VeenaveeSamarasinghe/-User-Presence-Based-Smart-Table-Lamp-with-Study-Time-Tracking-Application/Control board.jpg

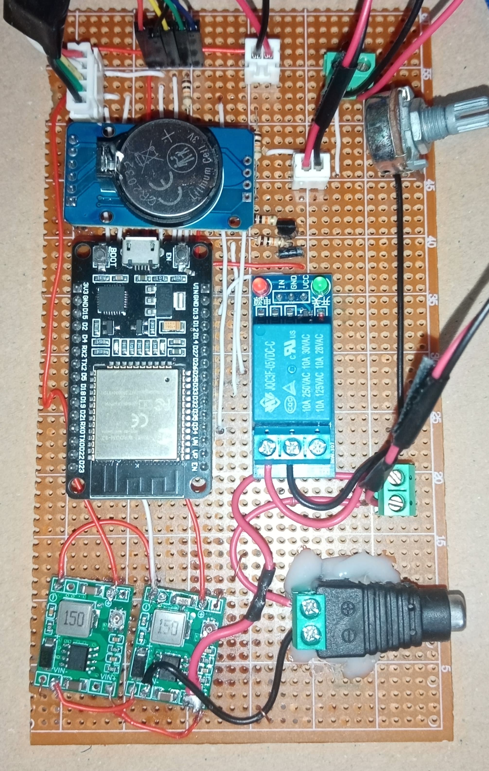
Control board.jpg
