VeenaveeSamarasinghe/-User-Presence-Based-Smart-Table-Lamp-with-Study-Time-Tracking-Application/Final Product.jpg

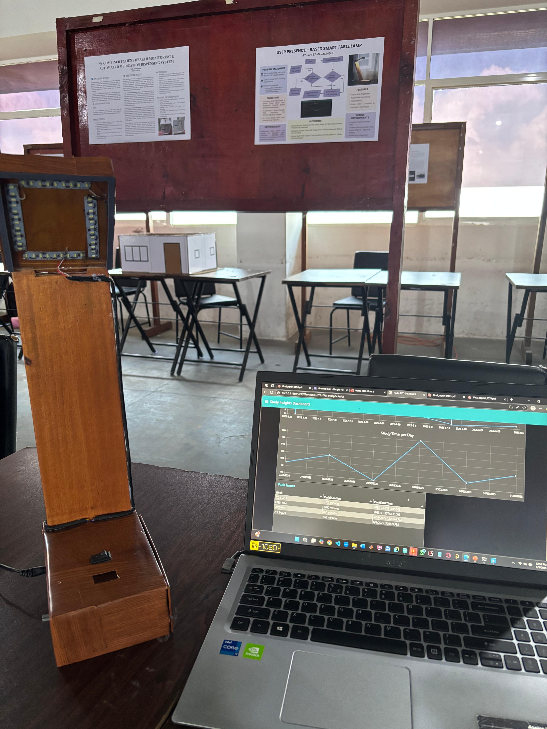
Final Product.jpg
