VeenaveeSamarasinghe/-User-Presence-Based-Smart-Table-Lamp-with-Study-Time-Tracking-Application/Final_detailed_Presentation.pdf

27-Jan-25 | Individual Design Project 2025

### D.N.V. SAMARASINGHE D/ENG/23/0053/ET STREAM : ET Final Presentation of Individual Design Project

# USER PRESENCE - BASED SMART TABLE LAMP

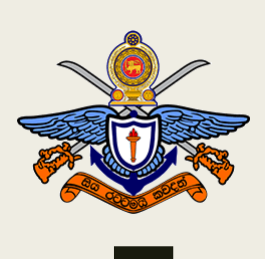
[picture p3: figure]

# Content of the Presentation

■ | Problem Identification
■ | Objectives
■ | Literature Review
■ | Market Survey
■ | System Design
■ | Flow Chart
■ | Critical Design Decisions
■ | Circuit Design
■ | Software implementation
■ | Results and discussion
■ | Problems Encountered and Solutions
■ | Cost Estimation
■ | Gantt Chart
■ | References
27-Jan-25 | Individual Design Project 2025 | 2

# Problem

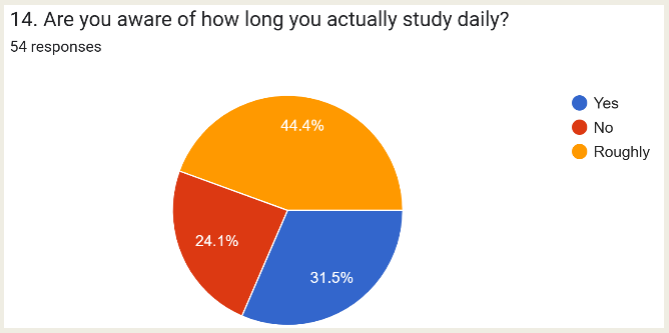
[picture p4: figure]

# Identification

## ■ Manually turning the lamp on and off is inconvenient

## ■ Lack of Study Time Tracking

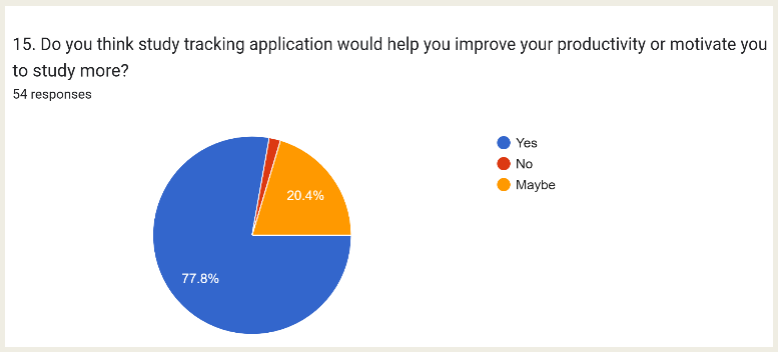
[picture p5: figure]

27-Jan-25 | Individual Design Project 2025 | 3

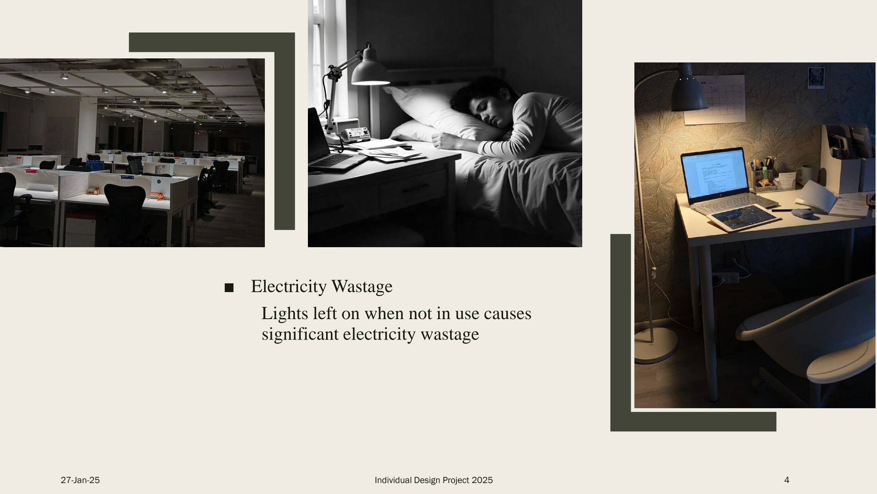
[picture p6: page 4]

## ■ Electricity Wastage

## Lights left on when not in use causes significant electricity wastage

27-Jan-25 | Individual Design Project 2025 | 4

# Objectives

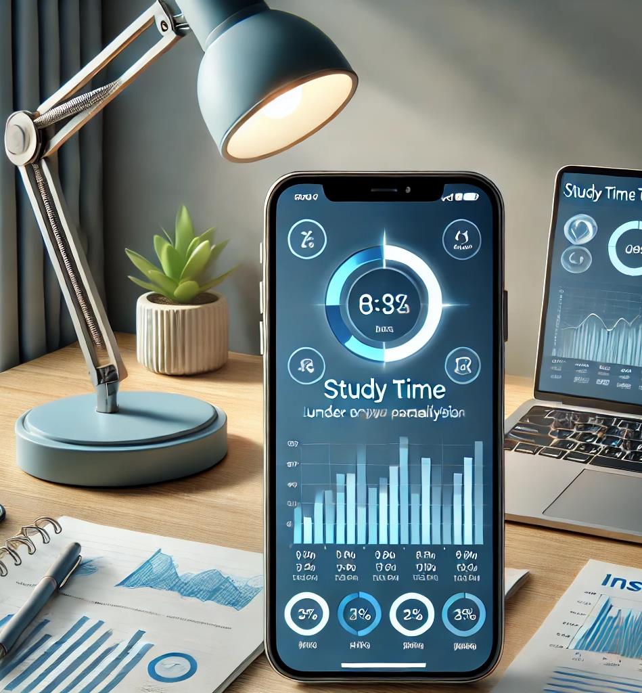
[picture p7: figure]

## 1. To design and implement a smart table lamp with

automatic control based on user preferences.

## 2. To develop a user-friendly web interface for

monitoring lamp usage.

3. To track study time and analyze user patterns.
27-Jan-25 | Individual Design Project 2025 | 5

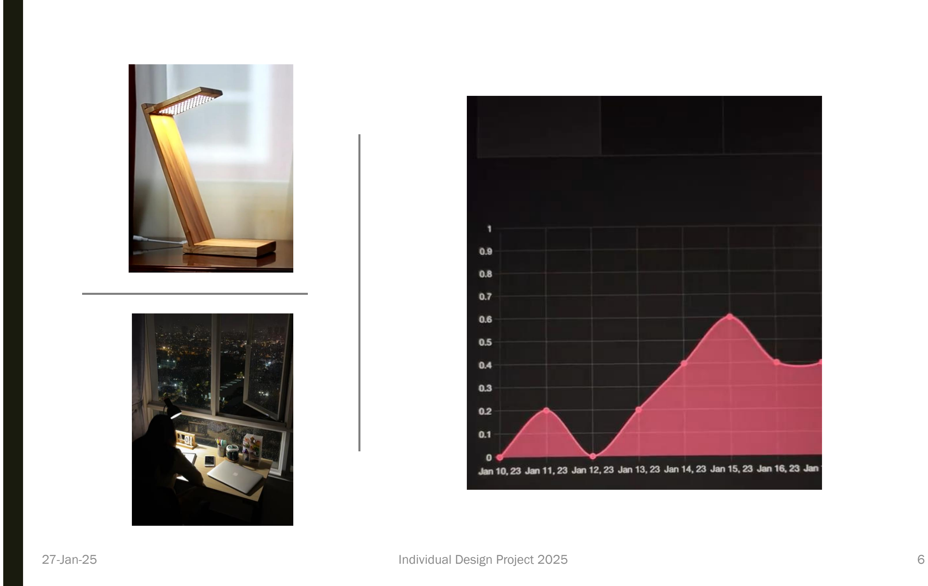
[picture p8: page 6]

27-Jan-25 | Individual Design Project 2025 | 6

# Literature Review

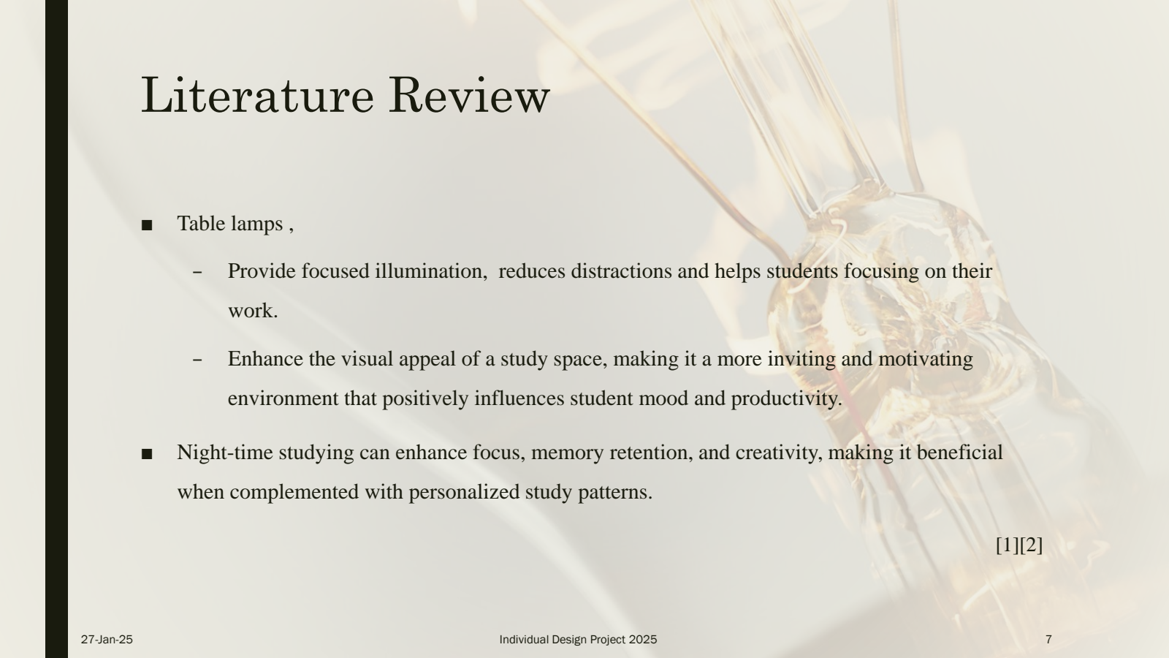
[picture p9: page 7]

■ | Table lamps ,
– | Provide focused illumination, reduces distractions and helps students focusing on their

work.

### – Enhance the visual appeal of a study space, making it a more inviting and motivating

environment that positively influences student mood and productivity.

■ Night-time studying can enhance focus, memory retention, and creativity, making it beneficial

when complemented with personalized study patterns.

[1][2]

27-Jan-25 | Individual Design Project 2025 | 7

Individual Design Project 2025 | 8

### - Energy Consumption and Emissions in Sri Lanka

In 2022, Sri Lanka's energy-related CO₂ emissions reached 18 million tonnes, contributing to 0.05% of

global emissions. There’s a 74% increase in emissions since 2000, highlighting the need for energy-efficient

### solutions. [3]

### - Energy Efficiency of LED Lighting

LED lamps consume significantly less energy compared to incandescent or halogen bulbs, offering up to

85% energy savings.

Smart lighting systems that automatically adjust brightness reduces electricity consumption by 30%.

Additionally, leaving lights on unnecessarily contributes to 5-10% of household electricity bills. [4][5][6]

27-Jan-25

# Key technologies relevant to the project

17-Sep-23 | Individual Design Project 2024/2025 | 9
■ | Cloud Firestore is a real-time cloud database to store sensor readings, lamp status, and study
| session data.
■ | MQTT is a lightweight communication protocol used to transmit data from the ESP32 to
| Firebase efficiently.
■ | Node-RED is a low code programming tool that stores data using flow-based graphs and tables
| through a web-based dashboard.

# Sources relevant to the design choices

## ■ The Pomodoro Technique

– | Inspired the timer feature. A buzzer alerts the user after every 25 minutes of
| study to take a 5-minute break
| (for the demonstration buzzer alerts after 2 minutes )

■ Based on literature review, LED strips were used to ensure better energy efficiency.

■ Survey results showed brightness

control was important,

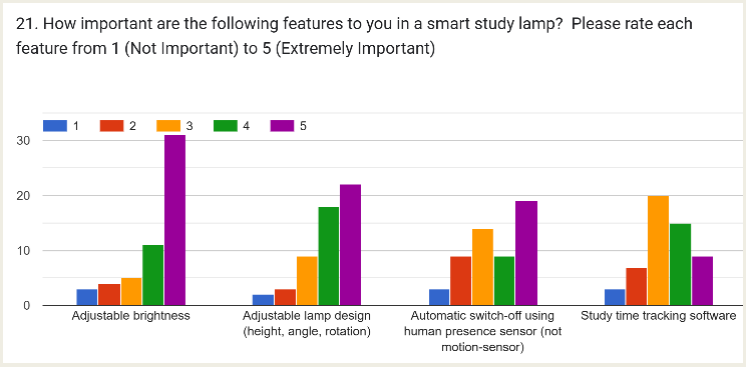
[picture p10: figure]

– A potentiometer was added

for manual adjustment,

– Lamp panel was made

adjustable in height, angle,

and rotation.

■ Many users preferred automatic

control,

– Human presence sensor

was used to switch the

lamp off

# Market Survey

Individual Design Project 2025 | 12
Lamp | Name | Features | Price | Available at

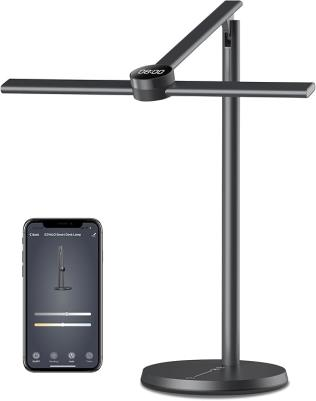
[picture p11: figure]

| EZVALO Smart Desk Lamp | APP Control Eye-Caring Auto-Dimming Led Desk Lamp 3 Color Temperature Works with Alexa & Google Assistant | LKR 17,812.89 | https://www.amazon.comhttps://rb.gy/qmpmoe

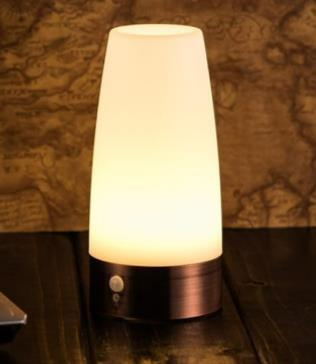
[picture p12: figure]

| ZEEFO Retro LED Night Light PIR Motion Sensor Light | Light will automatically turn on when a user pass within 6 feet of the sensor, will automatically turn off after about 15-20 seconds | LKR 4,845.08 | https://www.amazon.com/https://rb.gy/bpd5t2

27-Jan-25

Individual Design Project 2025 | 13
Lamp | Name | Features | Price | Available at

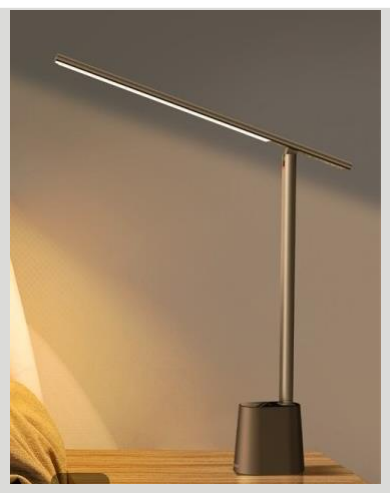
[picture p13: figure]

| Baseus LED Desk Lamp Auto-Dimming Table Lamp | 47 " Wide Rectangular Illumination Adjustable Brightness Built-in battery staying up to 13 hrs. | LKR 10,122.34 | https://baseusonline.com/https://rb.gy/d997z4

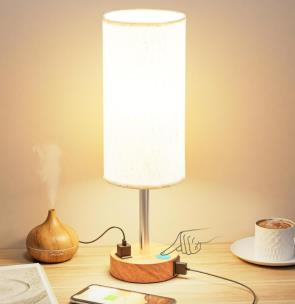
[picture p14: figure]

| 3 Way Dimmable Touch Lamp | Touch Control USB & USB-C Charging Ports and outlet | LKR 5,648.13 | https://www.amazon.com/https://rb.gy/8pntbj
| Xiaomi Mi Smart LED Desk Lamp | Adjustable brightness and color temperature App-controlled Lacks advanced motion detection | LKR 25,724.99 | https://www.aliexpress.com/item/32967694580.html (https://www.aliexpress.com/item/32967694580.html) https://www.mi.com/ae/product/mi-smart-led-desk-lamp-pro/ (https://www.mi.com/ae/product/mi-smart-led-desk-lamp-pro/)

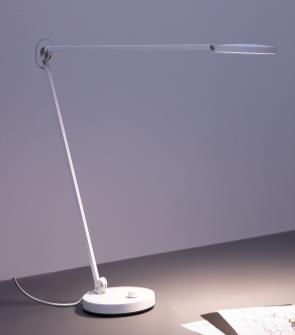
[picture p15: figure]

27-Jan-25

# Potential user base and application areas

■ | Students and Academics

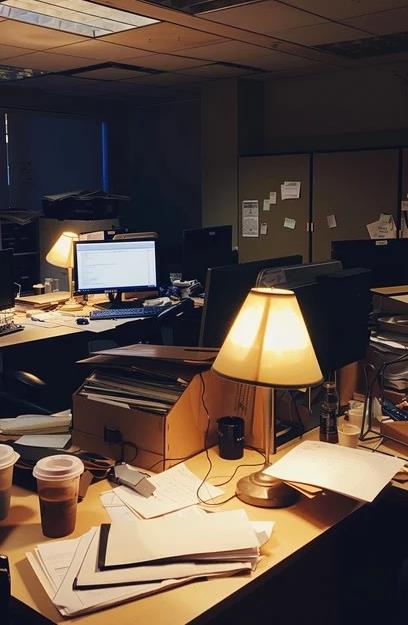
[picture p16: figure]
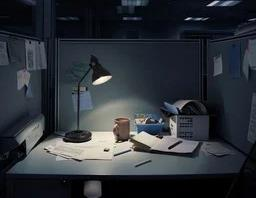
[picture p17: figure]

– | Hostel students who share rooms can

### have their own lighting without bothering their roommates

### – Feedbacks on lamp usage patterns can inspire better time management and study habits

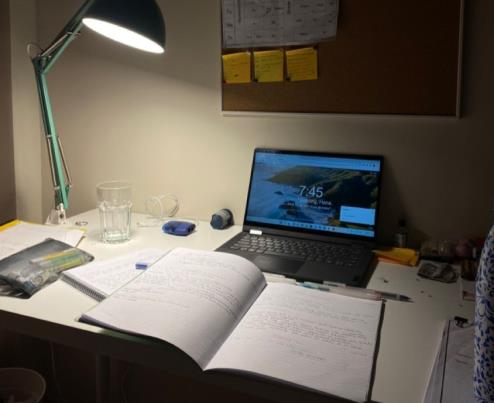
[picture p18: figure]

■ | Healthcare and Elderly Care
– | Enhance safety and provide hands-free

### operation for people with limited

mobility.

■ | Office and Workspace Settings
– | For busy office environments where

### users frequently move

27-Jan-25 | Individual Design Project 2025 | 14

# System Design

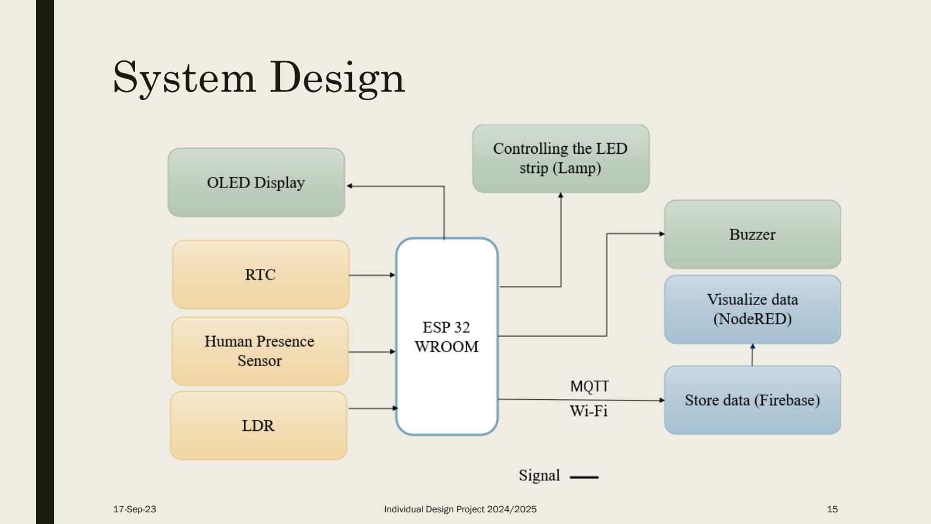
[picture p19: page 15]

# Flow chart

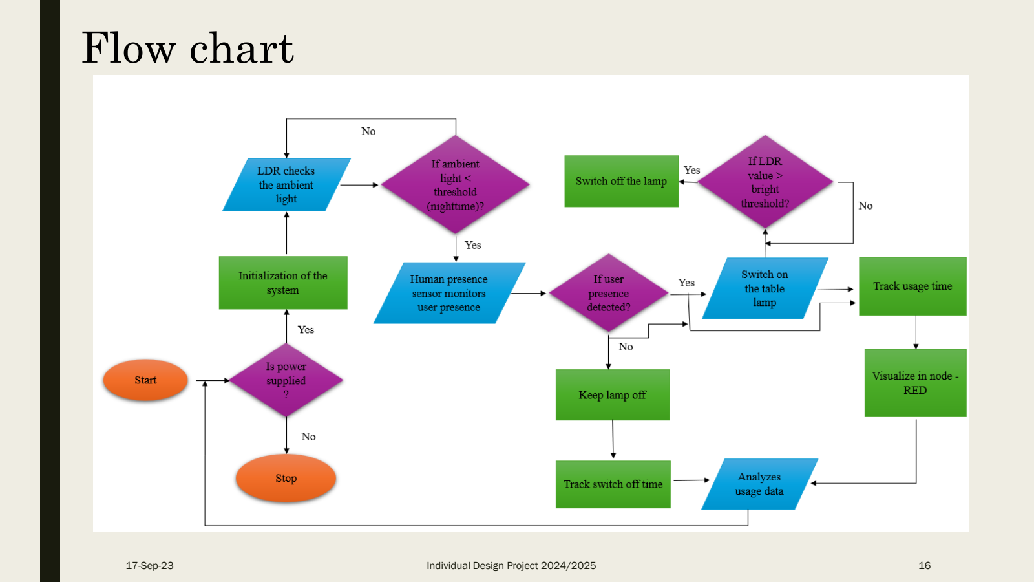
[picture p20: page 16]

## Flows of the Node-RED Dashboard for Study Time Analysis

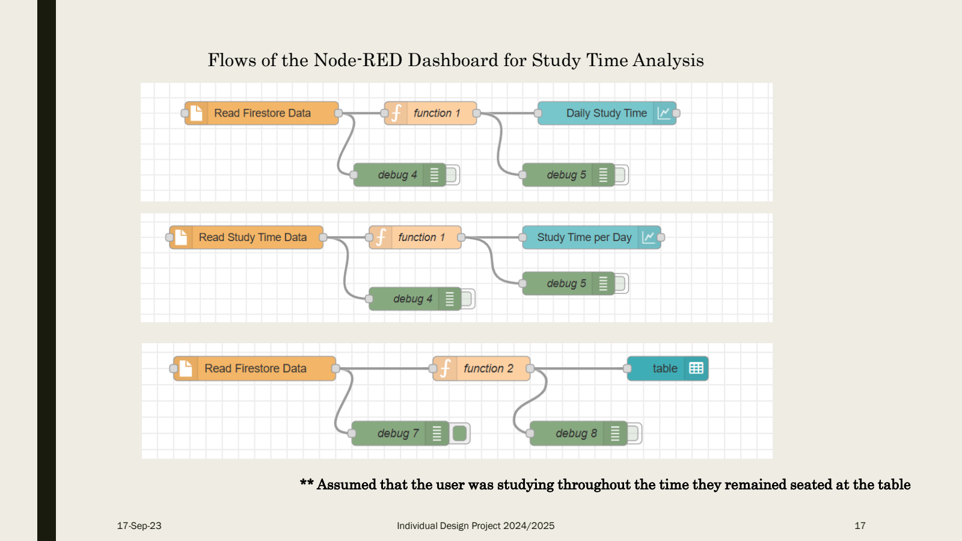
[picture p21: page 17]

** Assumed that the user was studying throughout the time they remained seated at the table

Side view | Front view

# 3-Dimensional view

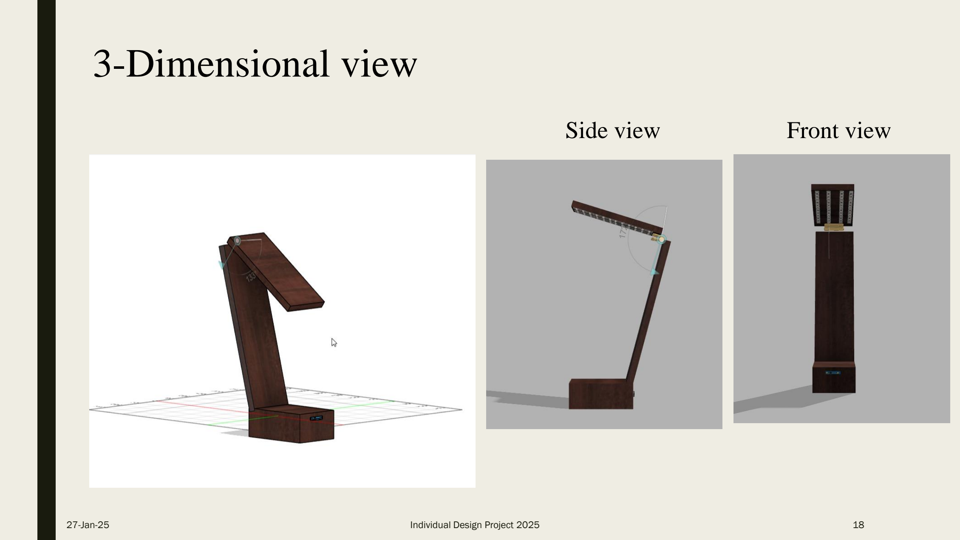
[picture p22: page 18]

Individual Design Project 2025 | 18

27-Jan-25

# Critical Design Decisions

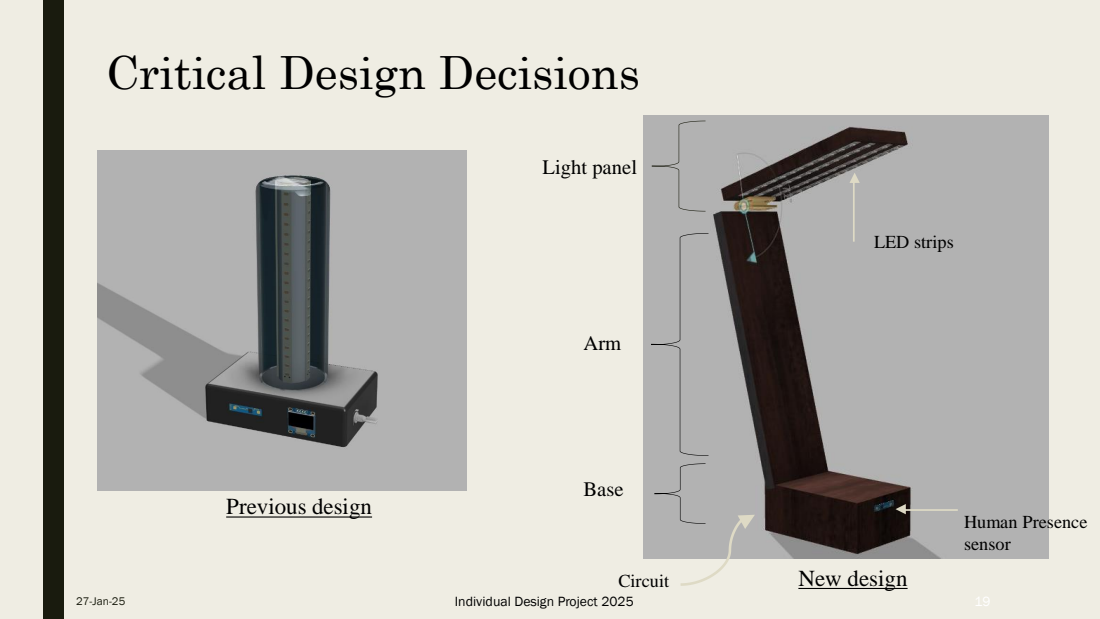
[picture p23: page 19]
Individual Design Project 2025; Previous design; New design; LED strips; Human Presence sensor; Circuit; Light panel; Arm; Base; 27-Jan-25

## ■ Focused Light Projection

The lamp is designed to direct light to a specific area instead of spreading it everywhere.

## ■ Wooden Casing

## to minimize heat transfer as the LED strips generate some heat when powered for long

periods.
maintaining an aesthetic look.

## ■ Adjustable Panel

Allow the user to change the lighting angle for different tasks.

## ■ Dual Power Options

To increase portability and ensure the lamp can work even during power outages.

## 12V adapter (for continuous use)

12V battery pack (for backup use).

■ The lamp projects light over approximately 1 meter with a 180-degree spread.

27-Jan-25 | Individual Design Project 2025 | 20

# Base enclosure 3D view

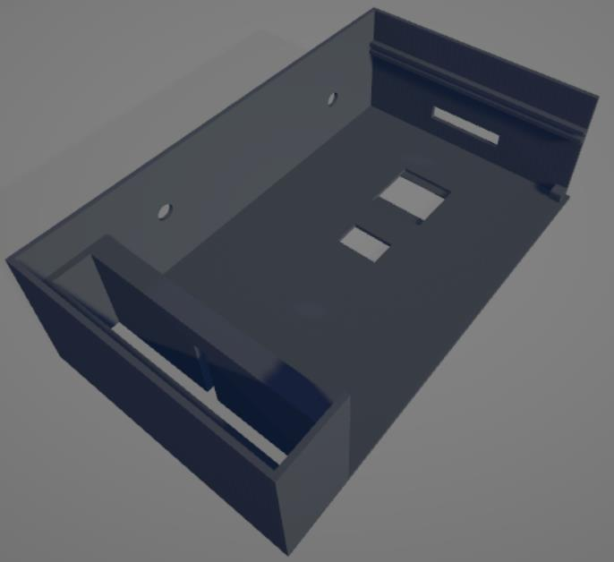
[picture p24: figure]
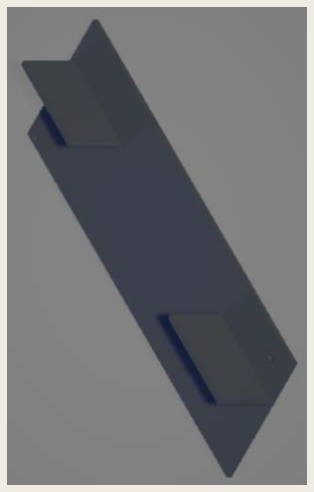
[picture p25: figure]
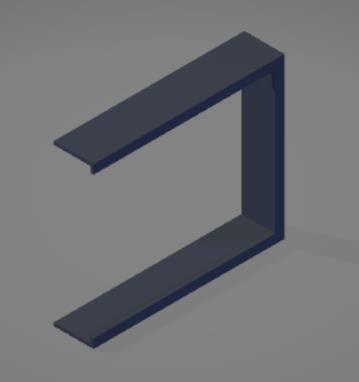
[picture p26: figure]

Casing | Slider | Panel casing

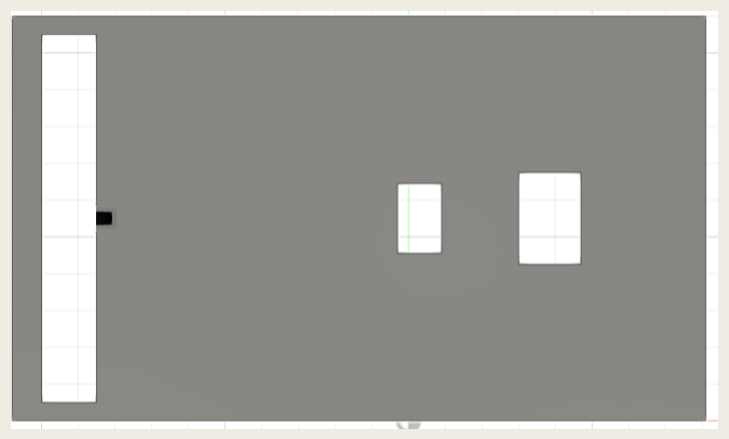
[picture p27: figure]
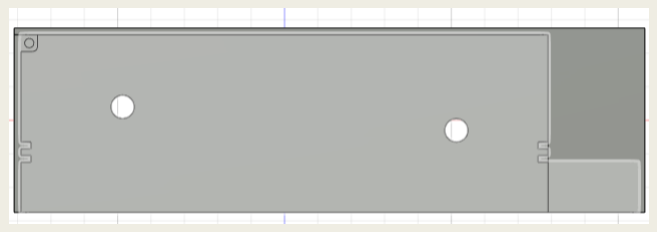
[picture p28: figure]

Top view | Side view

# Circuit

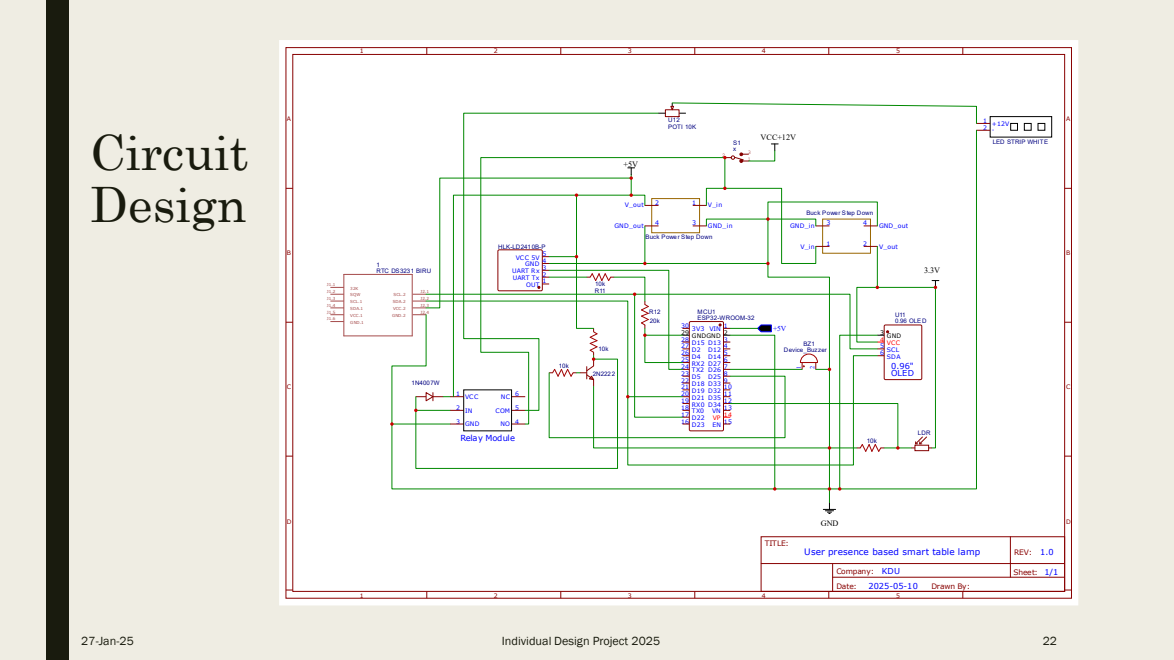
[picture p29: page 22]
Individual Design Project 2025; Design; 27-Jan-25

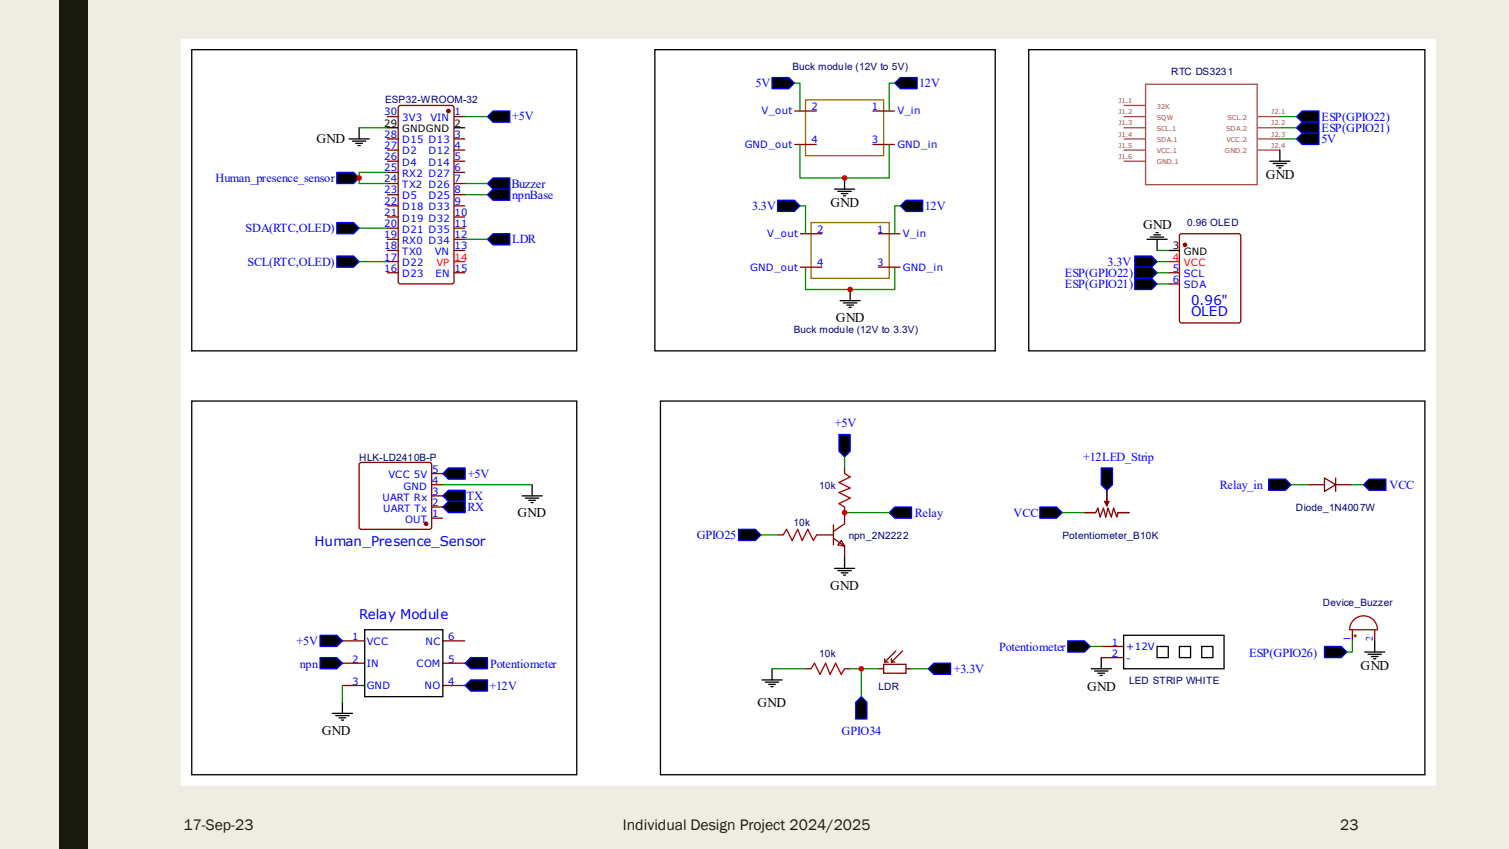
[picture p30: page 23]
n n ase; elay; elay in; otentiometer; tri

man resence sensor

# Software Implementation

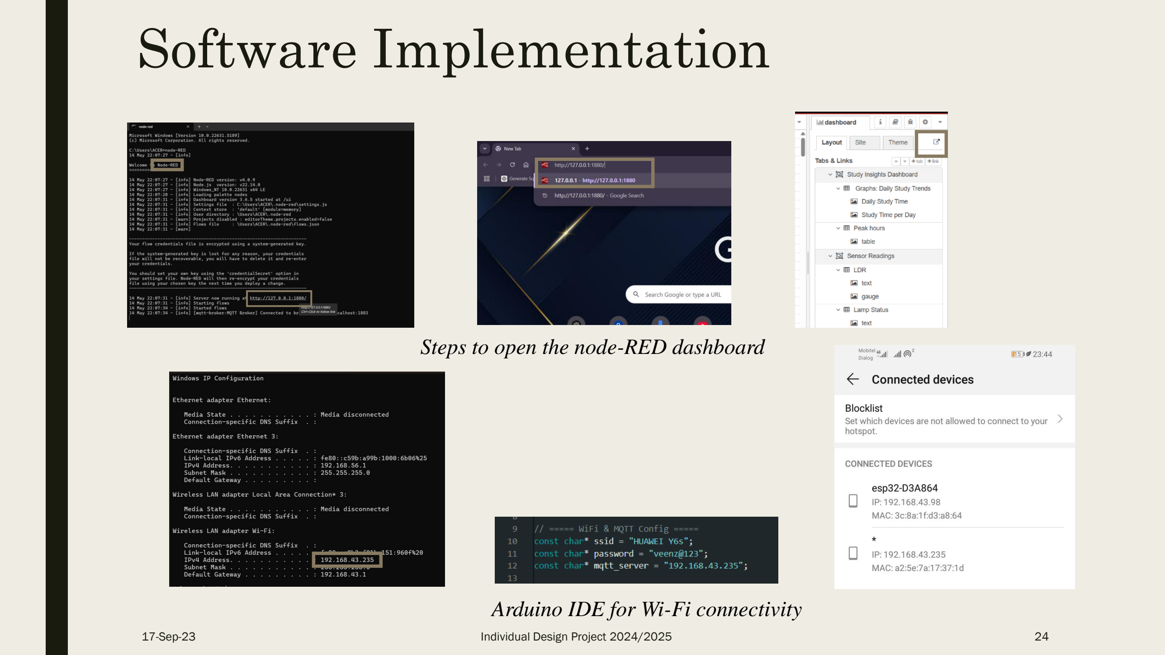
[picture p31: page 24]

### Arduino IDE for Wi-Fi connectivity

### Steps to open the node-RED dashboard

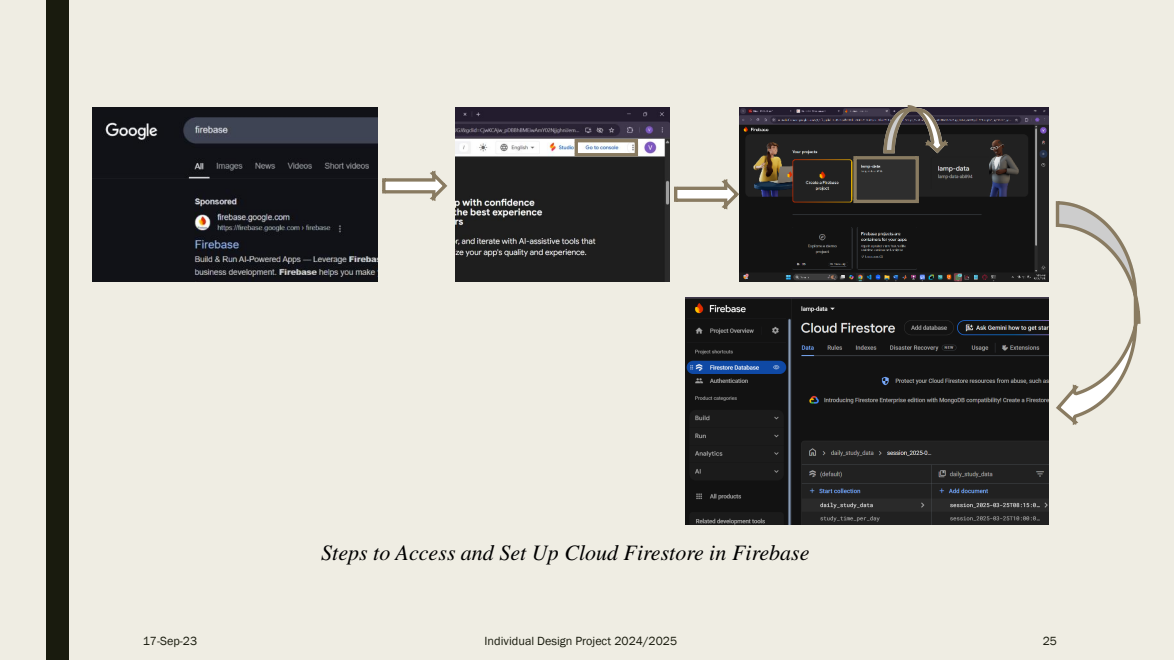
[picture p32: page 25]

Steps to Access and Set Up Cloud Firestore in Firebase

Purpose | Software
3D design | Fusion

## Solidworks

Database | Cloud firestore
Web interface | NodeRED
Circuit design | Easyeda
Code | Arduino IDE
Run node-red | Command window

## Softwares used

# Final views and Operation

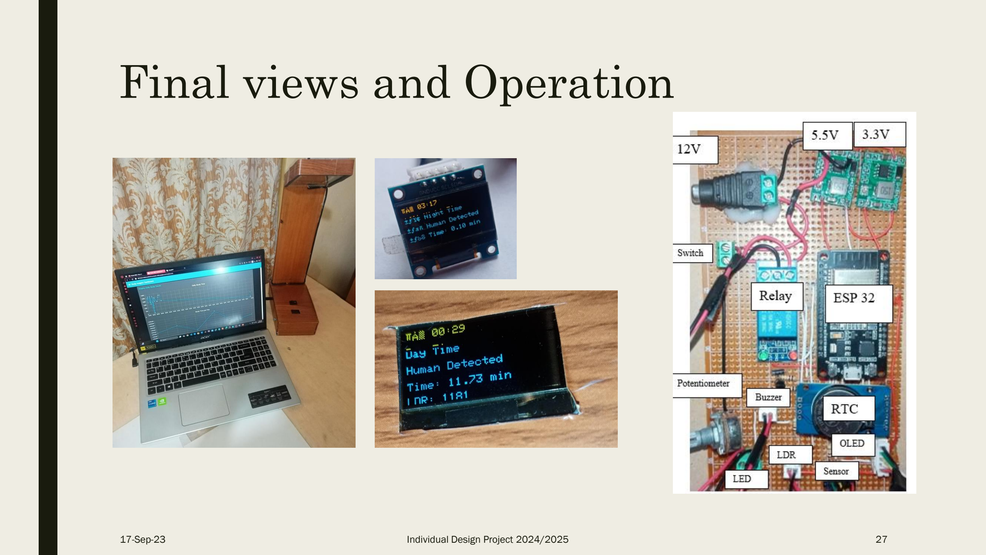
[picture p33: page 27]

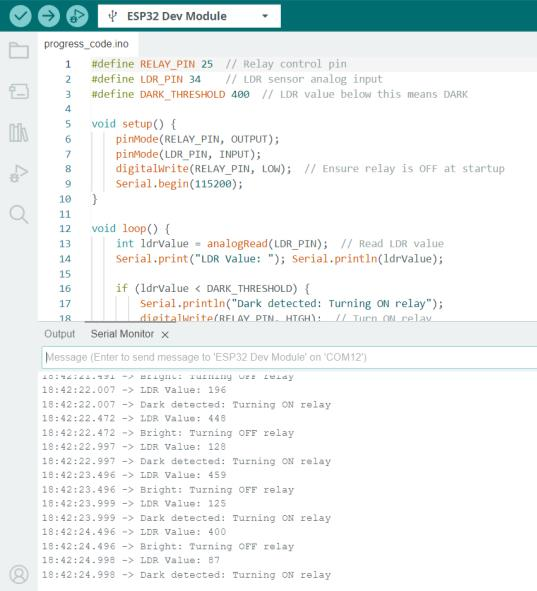
[picture p34: figure]

# Calibrations and results

## - Darkness detection threshold: 600 (calibrated based on the testing environment)

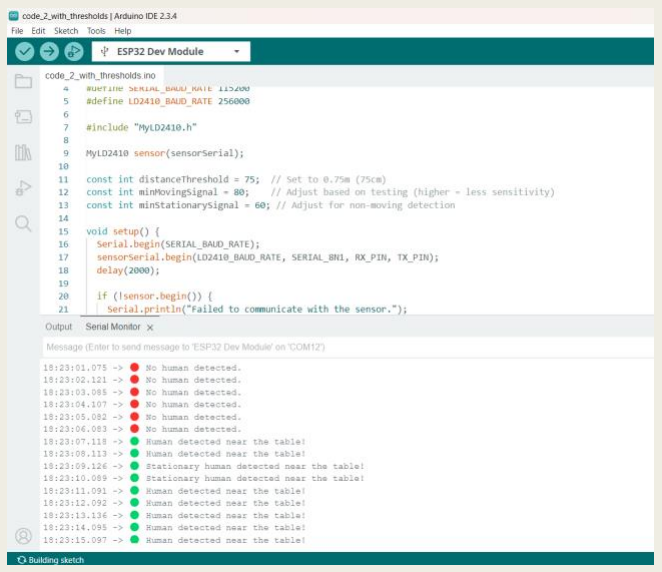
[picture p35: figure]

## - Bright threshold : 2500

## - Lamp activation condition: The lamp turns on when the darkness threshold is reached AND the brightness threshold is not reached

## - User presence detection threshold: 0.75m

27-Jan-25 | Individual Design Project 2025 | 28

# Results and Discussion

LDR after calibration

Human presence detection sensor after calibration

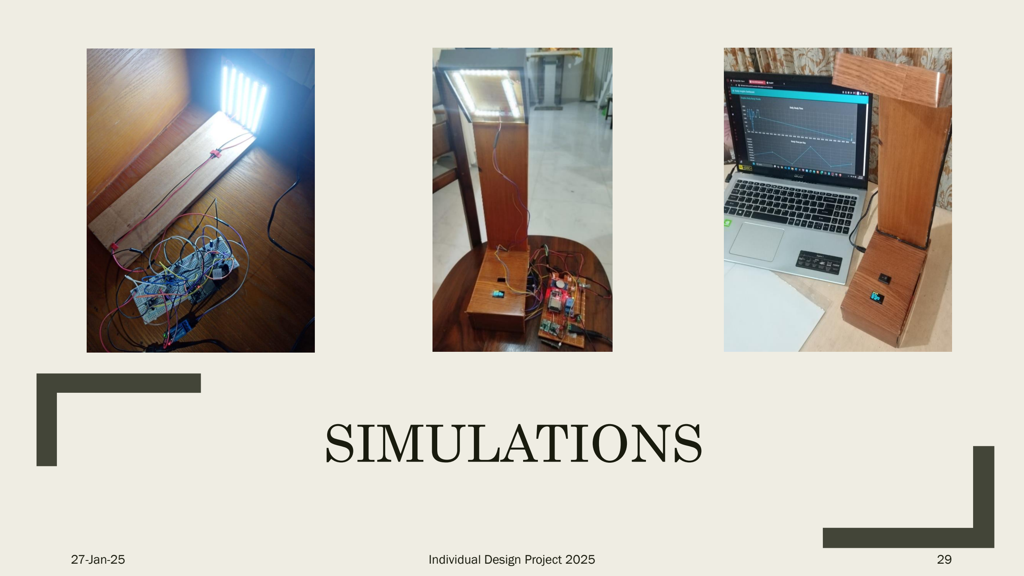
[picture p36: page 29]

# SIMULATIONS

27-Jan-25 | Individual Design Project 2025 | 29

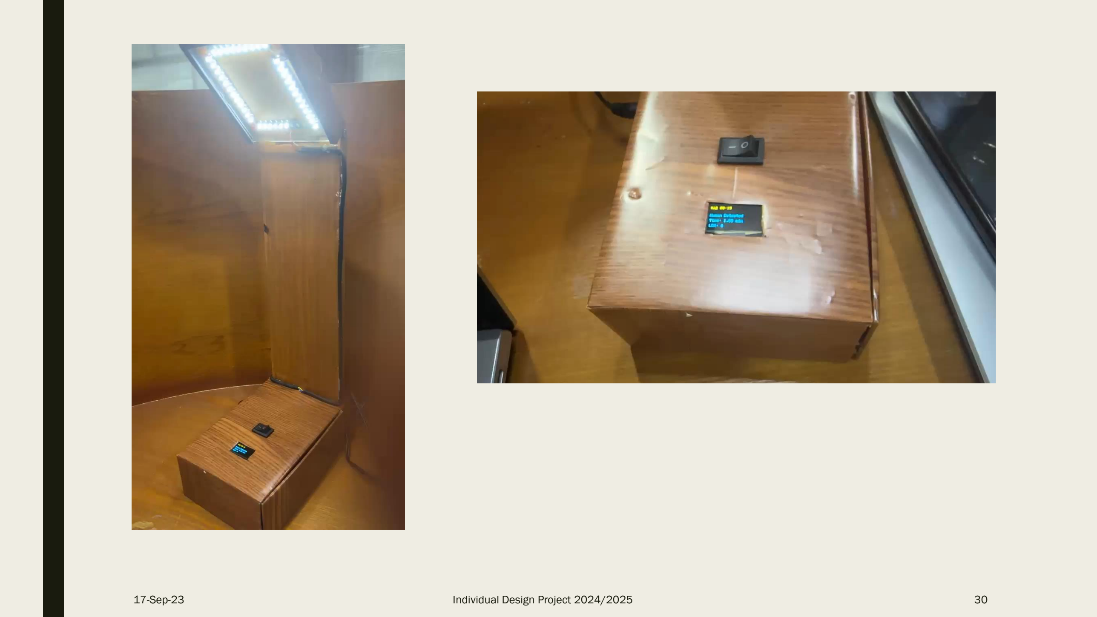
[picture p37: page 30]

## OLED Displays human detection status, minutes studied, and current LDR value

After every 25 minutes, a buzzer alerts the user to take a break simulating Pomodoro technique (for

the demonstration the buzzer alerts every 2 minutes).

Every 1 second, the system checks if a human is within range using human presence sensor.

If conditions are met, it updates status and study time begins.

MQTT is used to send messages about human presence ("entered"/"left") to the broker (via Firebase).

# Node-RED Dashboard

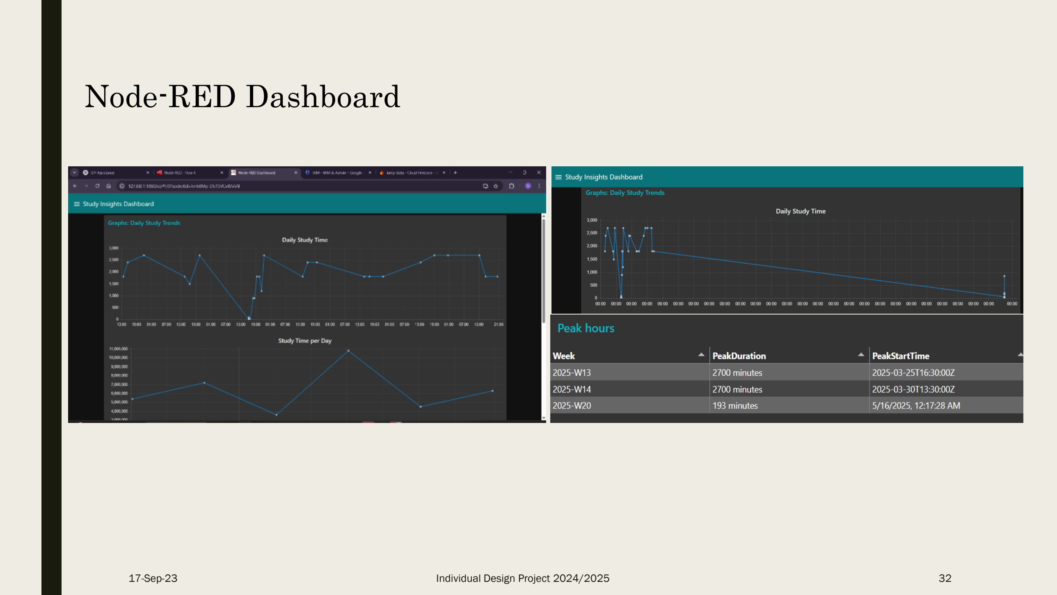
[picture p38: page 32]

Issue | Solution

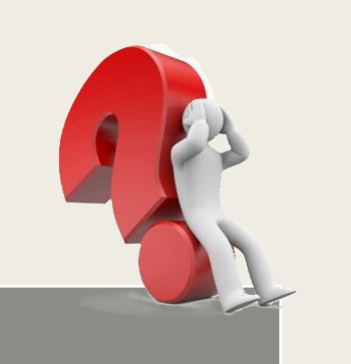
[picture p39: figure]

The PIR sensor could only detect motion, so it wasn’t reliable for knowing if someone was there throughout a time period. | Switched to the microwave radar sensor, which can continuously detect human presence.
The sensor's pins are very close together (1.27mm), making it hard to solder. | Use pin connectors with the precise gap between pins without soldering
The openings for external components like the potentiometer and DC jack were not aligned correctly in the initial 3D-printed enclosure design. | The enclosure openings were adjusted manually by heating and widening the holes using a soldering iron.
The human presence sensor has its own software for tuning, but the TTL converters didn’t work for it. | Tested example codes from some library and calibrated the sensor manually.
The radar sensor gave false readings, varying the detected distance continuously, and sometimes detected non-human objects also. | Reduced the sensor’s sensitivity, ignored non-human targets, and set the code to detect only human within a specific distance.
Individual Design Project 2025 | 33

# Problems Encountered and Solutions

27-Jan-25

# Possible further improvements

■ A more compact circuit design using a PCB to reduce size and cost.

## ■ The relay module was CAN be replaced with an IRLZ44N MOSFET, and

buck converters with L7805 voltage regulators.

■ A smaller microcontroller chip may be used instead of the full ESP32 board.

## ■ Dual power options including USB and battery were considered, along with

a charging reminder system.

■ Mobile app integration was also suggested to improve user convenience.

# Cost Estimation

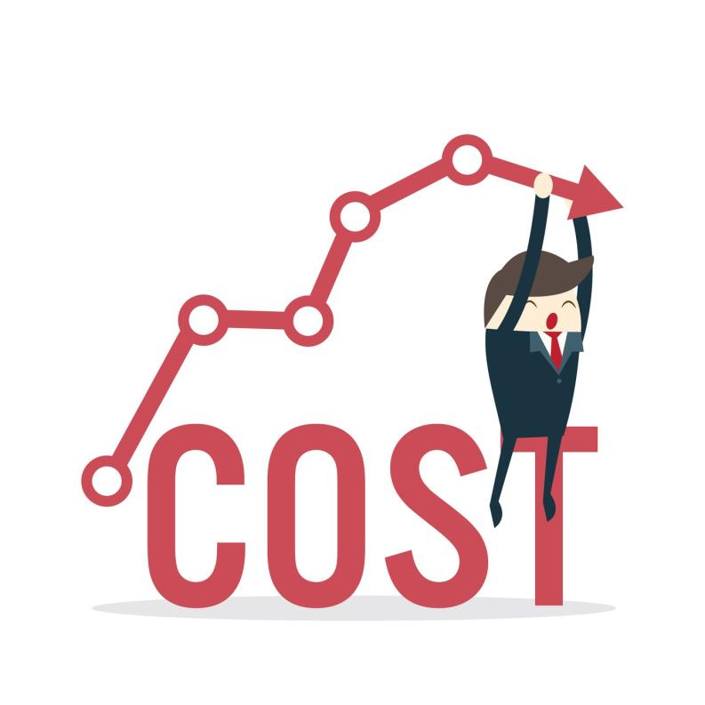
[picture p40: figure]

27-Jan-25 | Individual Design Project 2025 | 35
Component | Cost (lkr)
Human presence sensor | 1,400
ESP-WROOM-32 microcontroller | 1,300
LED Strip | 200
12V 2A SMPS adaptor | 650
OLED screen | 500
1 Channel Relay module | 350
Real Time clock memory module | 380
Step down Buck module *2 | 300
Vero board (dot board) | 220
LDR, Buzzer, Switch, DC Jack Barrel Connector, Potentiometer (10k) | 30 + 40 + 10 + 60 + 30 = 170
Miscellaneous Components | 500
3D print | 2500
Total | 8470/=

■ | The lamp was not fully 3D printed due to cost constraints. Wood was used for the panel and link
| parts to reduce expenses.
■ | Only the base enclosure was 3D printed using grey PLA+, with 100% infill for strength.
■ | The base of the enclosure was first made using wood to cut down costs.
■ | Wood-finish filaments were avoided as they were nearly twice the price.

■ A wooden-texture sticker was added to the enclosure for a uniform appearance.

# Cost-saving measures implemented

# Gantt Chart

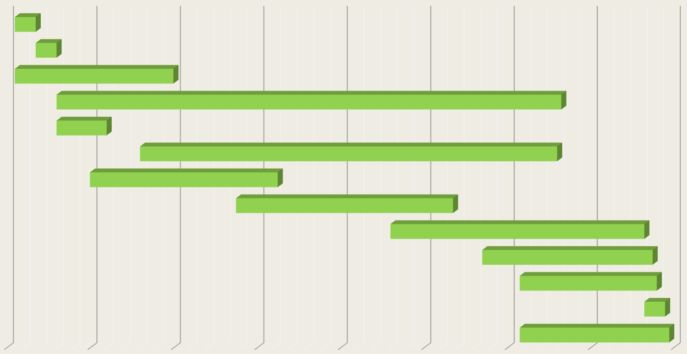
[picture p41: figure]

27-Jan-25 | Individual Design Project 2025 | 37
12/8/2024 | 12/28/2024 | 1/17/2025 | 2/6/2025 | 2/26/2025 | 3/18/2025 | 4/7/2025 | 4/27/2025 | 5/17/2025

Problem identification

Project proposal preparation

Data collection

Implementation

Sensor selection

3D designing

Acquire necessary components

Sensor calibration

Hardware assembly

Software development

Testing

Set up the demonstration

Documentation

Duration

# References

[1] “Why t dying at ight is est - cholarly log,” scholarly.so, Aug. 18, 2023. https://scholarly.so/blog/why-studying-at-night-is-best (https://scholarly.so/blog/why-studying-at-night-is-best)
[2] . ixit, “ enefits Of Table am For t dy - Woomdecor y ome ecor tems Online,” Woomdecor Buy Home Decor Items Online, Aug. 07, 2024. https://www.woomdecor.in/blog/benefits-of-table-lamp-for-study/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 (accessed Feb. 09, 2025).

[ ] “ ri anka - Co ntries & egions,” IEA. https://www.iea.org/countries/sri-lanka

[4] “Fact heet W | O | FO | T | Y | Wireless Occ ancy ensors for ighting
Controls.” vailable: htt s://betterb ildingssol tioncenter.energy.gov/sites/defa lt/files/attachments/Wireless-Sensors-Guidance.pdf
[5] Valentín Bladimir Palacios-Intriago, D. D. Rezabala-Cedeño, and W. L. Vera-Cevallos, “ lights and their im act on energy savings in a residential environment,” International journal of engineering & computer science, vol. 7, no. 1, pp. 8– 11, Aug. 2024, doi: https://doi.org/10.21744/ijecs.v7n1.2306.

[ ] “2017 U. . nergy and m loyment e ort,” Energy.gov. https://www.energy.gov/policy/articles/2017-us-energy-and-employment-report

27-Jan-25 | Individual Design Project 2025 | 38

# THANK YOU

24-Jan-25 | Individual Design Project 2025 | 18
