VeenaveeSamarasinghe/-User-Presence-Based-Smart-Table-Lamp-with-Study-Time-Tracking-Application/Base Enclosure.png

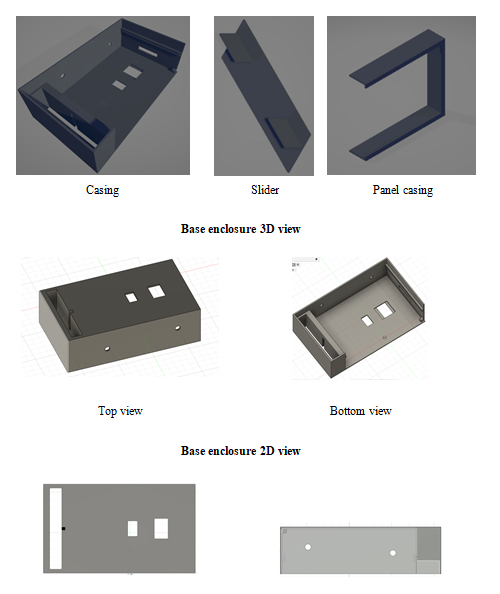
Base Enclosure.png
