VeenaveeSamarasinghe/-User-Presence-Based-Smart-Table-Lamp-with-Study-Time-Tracking-Application/IDP Expo ' 25.jpg

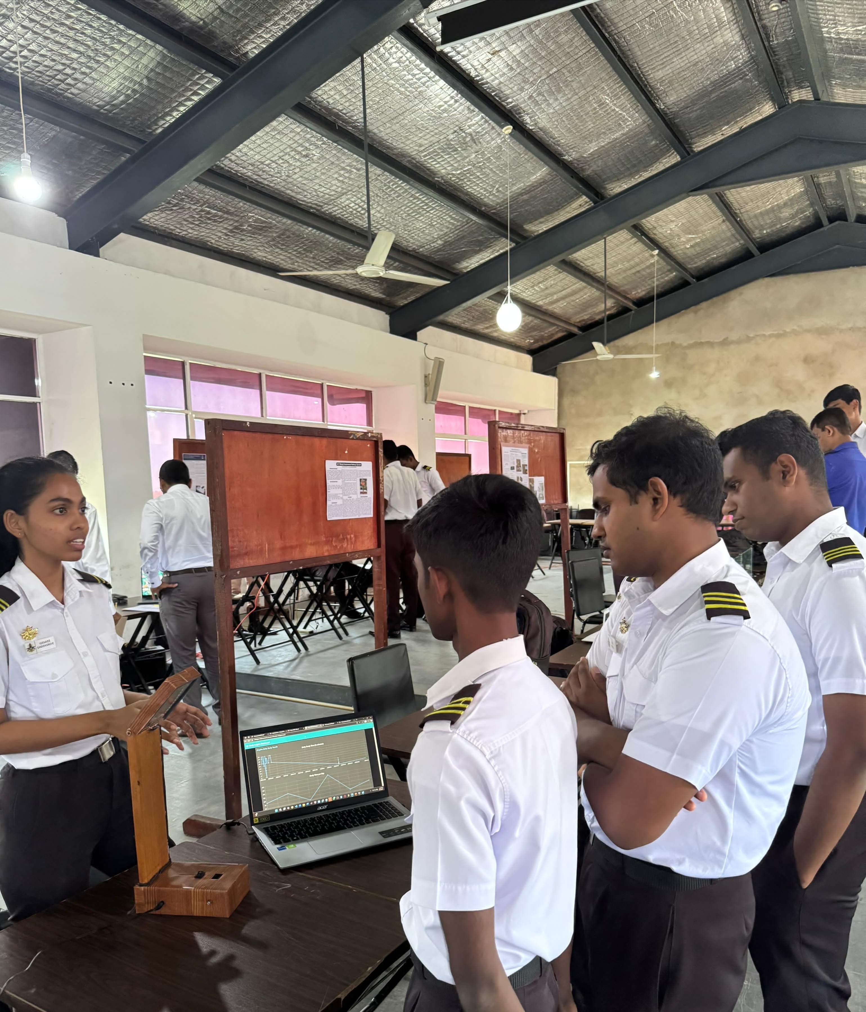
IDP Expo ' 25.jpg
