VeenaveeSamarasinghe/-User-Presence-Based-Smart-Table-Lamp-with-Study-Time-Tracking-Application/Poster.pdf

# User presence - Based Smart table Lamp

# By DNV samarasinghe

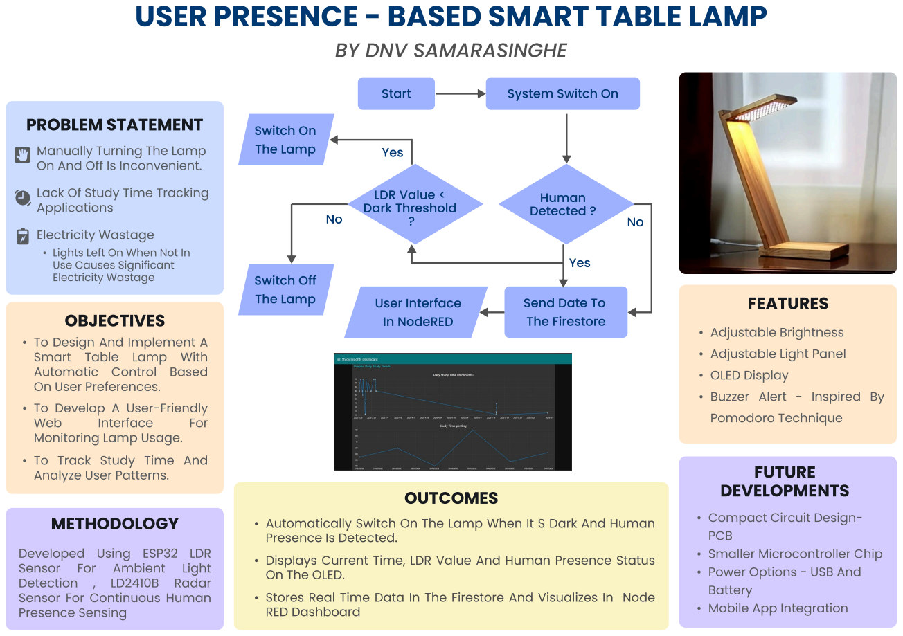
[picture p47: page 1]
applications; Electricity Wastage; Problem statement; start; System switch on; the firestore; LDR value <; dark threshold ?; human; detected ?; yes; User interface; in nodeRED; Switch off; the lamp; Switch on; Objectives; smart; table; lamp with; automatic; control; based; web; interface; for; methodology; Developed; using ESP32; LDR; sensor; ambient; light; detection; radar; outcomes; features; q Adjustable brightnes; q OLED Displa; q Buzzer alert; Inspired by; Pomodoro Technique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

Manually turning the lamp

on and off is inconvenient.

Lack of Study Time Tracking

q Lights left on when not in
use causes significant
electricity wastage

Send date to

q To design and implement a

q Adjustable light pane

on user preferences.

q To develop a user-friendly

monitoring lamp usage.

q To track study time and

analyze user patterns.

q Compact circuit design

q Automatically switch on the lamp when it s dark and human

presence is detected.

q Smaller microcontroller chiU

q Displays Current time, LDR Value and human presence status
on the OLED.

q Stores real time data in the firestore and visualizes in Node
RED Dashboard

sensor for continuous human
presence sensing

q Mobile app integration
